Re-Alise/Dualshock-2-Input-Overlay/images/bypass-schematic.png

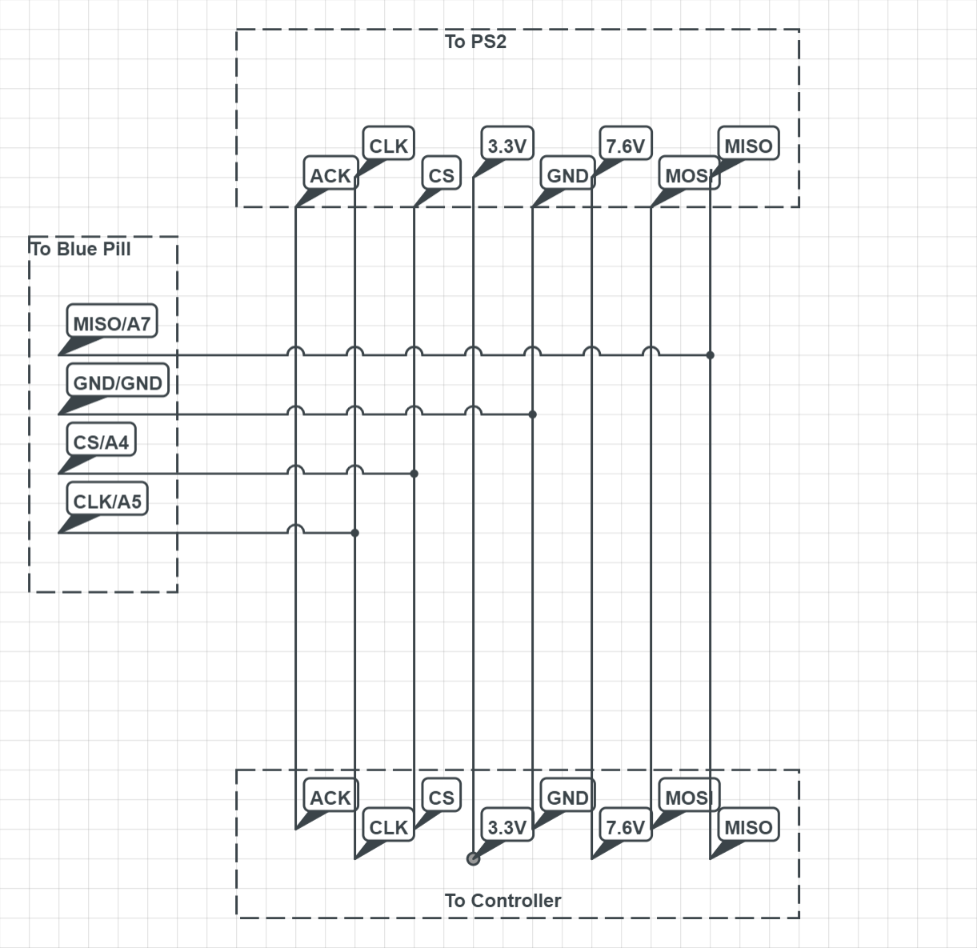
images/bypass-schematic.png
