Re-Alise/Dualshock-2-Input-Overlay/ds2_overlay/main.c

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
/* Includes ------------------------------------------------------------------*/
#include "main.h"
#include "usb_device.h"

/* USER CODE BEGIN Includes */
#include "usbd_cdc_if.h"
/* USER CODE END Includes */

SPI_HandleTypeDef hspi1;

UART_HandleTypeDef huart3;

/* USER CODE BEGIN PV */
volatile uint8_t rx_flag = 0;
const uint8_t usb_padding_byte = 0x45;
const uint8_t usb_padding_count = 0x45;
uint8_t command_byte_count = 0;
uint8_t ds_mode = 0;
uint8_t miso_data[24] = { 0 };
/* USER CODE END PV */

void SystemClock_Config(void);
static void MX_GPIO_Init(void);
static void MX_SPI1_Init(void);
static void MX_USART3_UART_Init(void);
/**
  * @brief  The application entry point.
  * @retval int
  */
int main(void)
{
  /* MCU Configuration--------------------------------------------------------*/

  /* Reset of all peripherals, Initializes the Flash interface and the Systick. */
  HAL_Init();

  /* Configure the system clock */
  SystemClock_Config();

  /* Initialize all configured peripherals */
  MX_GPIO_Init();
  MX_SPI1_Init();
  MX_USART3_UART_Init();
  MX_USB_DEVICE_Init();
  /* Infinite loop */
  /* USER CODE BEGIN WHILE */
	while (1) {
    /* USER CODE END WHILE */

    /* USER CODE BEGIN 3 */
		switch (rx_flag) {
		case 0:
			// Get first 3 bytes from MISO of controller
//			HAL_GPIO_TogglePin(GPIOC, GPIO_PIN_15);
//			HAL_GPIO_TogglePin(GPIOC, GPIO_PIN_15);
//			HAL_GPIO_TogglePin(GPIOC, GPIO_PIN_15);
			HAL_SPI_Receive_IT(&hspi1, miso_data, 3);
			rx_flag = 1;
			break;
		case 2:
			// First 3 bytes received
			if (miso_data[2] != 0x5A || miso_data[0] != 0xFF) {
				// Controller's changing mode (miso_data[2] == 0x00) or a corrupted data
				rx_flag = 9;
//				HAL_GPIO_TogglePin(GPIOC, GPIO_PIN_15);
//				HAL_GPIO_TogglePin(GPIOC, GPIO_PIN_15);
//				HAL_GPIO_TogglePin(GPIOC, GPIO_PIN_15);
//				HAL_GPIO_TogglePin(GPIOC, GPIO_PIN_15);
				break;
			}

			// Get current mode of controller
			// High nibble indicates the mode of the controller (4 for digital, 7 for analog, F for config mode)
			// Low nibble indicates the length of incoming **16 bit** data
			ds_mode = miso_data[1];
			command_byte_count = (ds_mode & 0x0F) * 2;
			if (ds_mode != 0x41 && ds_mode != 0x73 && ds_mode != 0x79) {
				// Controller's in config mode (miso_data[1] == 0xF3) or a corrupted data, abort
				rx_flag = 9;
//				HAL_GPIO_TogglePin(GPIOC, GPIO_PIN_15);
//				HAL_GPIO_TogglePin(GPIOC, GPIO_PIN_15);
//				HAL_GPIO_TogglePin(GPIOC, GPIO_PIN_15);
//				HAL_GPIO_TogglePin(GPIOC, GPIO_PIN_15);
//				HAL_GPIO_TogglePin(GPIOC, GPIO_PIN_15);
				break;
			}

			// Get the rest of bytes
			HAL_SPI_Receive_IT(&hspi1, &miso_data[3], command_byte_count);
//			HAL_GPIO_TogglePin(GPIOC, GPIO_PIN_14);
			rx_flag++;
			break;
		case 4:
			// Output data through bluetooth or USB serial
			// I excluded the first byte as a workaround for my HM-10's 20 byte MTU size, which can not be changed
//			HAL_GPIO_TogglePin(GPIOC, GPIO_PIN_15);
//			HAL_GPIO_TogglePin(GPIOC, GPIO_PIN_15);
			if (command_byte_count > 6) {
				if (HAL_GPIO_ReadPin(GPIOB, GPIO_PIN_9) == GPIO_PIN_RESET) {
					// Send full length data if both side of your bluetooth device can handle this
					HAL_UART_Transmit_IT(&huart3, &miso_data[1], command_byte_count + 2);
				} else {
					// Truncate pressure data to improve stability
					// But it still laggy sometime in my case, especially using other BLE device at the same time
					HAL_UART_Transmit_IT(&huart3, &miso_data[1], 8);
				}
			} else {
				// Send full length data
				HAL_UART_Transmit_IT(&huart3, &miso_data[1], command_byte_count + 2);
			}

			// Add padding 0x45 to the end of stream, since there is no way to know the end of data in serial communication in this case?
			memset(&miso_data[command_byte_count + 3], usb_padding_byte, usb_padding_count);
			CDC_Transmit_FS(&miso_data[1], command_byte_count + 5);
			rx_flag++;
			break;
		default:
			break;
		}
	}
  /* USER CODE END 3 */
}

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
/* USER CODE BEGIN 4 */
void HAL_SPI_RxCpltCallback(SPI_HandleTypeDef *hspi) {
//	HAL_GPIO_TogglePin(GPIOC, GPIO_PIN_15);
	rx_flag++;
}

void HAL_UART_TxCpltCallback(UART_HandleTypeDef *huart) {
	HAL_GPIO_TogglePin(GPIOC, GPIO_PIN_13);
}

void HAL_GPIO_EXTI_Callback(uint16_t GPIO_Pin) {
	if (GPIO_Pin == GPIO_PIN_3) {
//		HAL_GPIO_TogglePin(GPIOC, GPIO_PIN_14);
		if (HAL_GPIO_ReadPin(GPIOA, GPIO_PIN_3) == GPIO_PIN_RESET) {
//			for (int i = 0; i < HAL_SPI_GetState(&hspi1); i++) {
//				HAL_GPIO_TogglePin(GPIOC, GPIO_PIN_14);
//			}
			if (HAL_SPI_GetState(&hspi1) != HAL_SPI_STATE_BUSY_RX) {
				// Should be always true in normal operation
				rx_flag = 0;
			}
		} else {
			if (HAL_SPI_GetState(&hspi1) == HAL_SPI_STATE_READY) {
				// Should be always true in normal operation
				HAL_SPI_Abort(&hspi1);
//				HAL_GPIO_TogglePin(GPIOC, GPIO_PIN_14);
			}
//			HAL_GPIO_TogglePin(GPIOC, GPIO_PIN_14);
		}
	}
}

//void HAL_SPI_ErrorCallback(SPI_HandleTypeDef *hspi) {
//	HAL_GPIO_WritePin(GPIOC, GPIO_PIN_13, GPIO_PIN_RESET);
//}
/* USER CODE END 4 */
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
