Re-Alise/Dualshock-2-Input-Overlay/ds2_overlay/ds2_overlay.ioc

PB9.GPIO_Label=GPIO_BLE_FULL_LENGTH
Mcu.UserName=STM32F103C8Tx
PC13-TAMPER-RTC.Signal=GPIO_Output
PD0-OSC_IN.Signal=RCC_OSC_IN
PC14-OSC32_IN.Signal=GPIO_Output
PB11.Signal=USART3_RX
PC15-OSC32_OUT.GPIO_Label=Debug_2
PD1-OSC_OUT.Signal=RCC_OSC_OUT
PA12.Signal=USB_DP
PC15-OSC32_OUT.Signal=GPIO_Output
PB10.Signal=USART3_TX
PA5.Signal=SPI1_SCK
PC13-TAMPER-RTC.GPIO_Label=LED
PA4.Signal=SPI1_NSS
PB9.Signal=GPIO_Input
PA11.Signal=USB_DM
PC14-OSC32_IN.GPIO_Label=Debug_1
PA3.GPIO_Label=EXTI3_CS
PA3.Signal=GPXTI3
PA7.Signal=SPI1_MOSI
