Re-Alise/Dualshock-2-Input-Overlay/(commit log)

2021-05-03 Add all files
    TODO: Insert demo video in readme
2021-05-03 Insert demo video in readme
    Video could not play properly however, upload original file soon.
