Re-Alise/Dualshock-2-Input-Overlay/(notices)

Notices in the files:
ds2_overlay/main.c:
© Copyright (c) 2021 STMicroelectronics.
All rights reserved.
This software component is licensed by ST under Ultimate Liberty license
(C) COPYRIGHT STMicroelectronics *****END OF FILE
